BlackbirdStandalone/ToothEater-Firmware/(list of files, drawings)

Other design files:
simulation/ToothEater.sim1
