BlackbirdStandalone/ToothEater-Firmware/src/ToothEater.c

/* -------------------------------------------------------------------------- */
/* Tooth Eater Firmware: v1.2                                                 */
/*                                                                            */
/* Copyright © 2026 Alex Kiaos                                                */
/*                                                                            */
/* Processor: atTiny85                                                        */
/* Licence:   GPLv3                                                           */
/* -------------------------------------------------------------------------- */

#include <avr/interrupt.h>

#include "main_defs.h"
#include "BB_Cam_To_SinglePulse.h"

/* Crank ISR                                                                  */
/*                                                                            */
/* This interrupt service routine fires on every positive crank edge.         */
/* The watchdog is routinely patted on every crank edge after initial cam     */
/* SYNC has been made.                                                        */
ISR (PCINT0_vect)
{
#ifdef INVERT_CRANK_INPUT
    if (!(PINB & (1 << CRANK_TRIG_IN)))
#else
    if (PINB & (1 << CRANK_TRIG_IN))
#endif
    {
#if (0)
        /* Check for hard lockup condition                                    */
        if (FLAGS & BIT_HARD_LOCKUP)
        {
            while(1) {}
        }
#endif
        /* Process crank edge                                                 */
        if (cam.state == SYNCED)
        {
#ifdef CPI_MODE
            /* --- Cam signal insertion ---                                   */
            if (0 == cam.nCrankModCount)
            {
#ifdef CAM_PULSES_ON_STARTUP_ONLY
                if (cam.nCamPulseCount < STARTUP_CAM_PULSES)
                {
                    CAM_OUTPUT_ON
                    ++cam.nCamPulseCount;
                }
                else
                {
                    CAM_OUTPUT_OFF
                }
#else
                CAM_OUTPUT_ON
#endif

                cam.nCrankModCount = CKP_PER_ENGINE_CYCLE;
            }
            else
            {
                CAM_OUTPUT_OFF
            }

            --cam.nCrankModCount;
            /* --- end Cam signal insertion ---                               */
#endif

#ifdef TACHO_ENABLE
            /* --- Tacho signal insertion ---                                 */
            if (0 == cam.nTachoModCount)
            {
                TACHO_TOGGLE

                cam.nTachoModCount = TACHO_HALF_PERIOD;
            }

            --cam.nTachoModCount;
            /* --- end Tacho signal insertion ---                             */
#else
            /* Test line to measure CPU load                                  */
            TACHO_ON
#endif
        }
        else
        {
            doCrankPulse();
        }

        /* Pat the watch dog, but only if past the 'UNINITIALISED' state,     */
        /* since the engine is now cranking or running                        */
        if (cam.state > UNINITIALISED)
        {
            WDG_PAT();
        }
    }
}

/* Cam ISR                                                                    */
/*                                                                            */
/* This interrupt service routine fires on every falling cam edge (default).  */
/* The NCV1124 VR chip was used during development and its output is inverted.*/
/* The state machine is driven by 'doCamPulse()' and the watchdog is always   */
/* patted once the first cam pulse has passed.                                */
/*   If a HARD LOCKUP is invoked, then this ISR is intentionally jammed to    */
/* invoke the WDG and reset the microcontroller.                              */
ISR (INT0_vect)
{
    if (FLAGS & BIT_HARD_LOCKUP)
    {
        while(1) {}
    }

    doCamPulse();

    /* Pat the watch dog, but only if past the 'UNINITIALISED' state, since   */
    /* the engine is now cranking or running                                  */
    if (cam.state > UNINITIALISED)
    {
        WDG_PAT();
    }
}

/* Configure cam ISR pin                                                      */
/* Enable the external interrupt line INT0                                    */
static void externalInterrupt(void)
{
    GIMSK |= (1 << INT0);

#ifdef INVERT_CAM_INPUT
    /* Fire cam ISR on falling edge                                           */
    MCUCR &= ~(1 << ISC00);
#else
    /* Fire cam ISR on rising edge                                            */
    MCUCR |= (1 << ISC00);
#endif

    MCUCR |= (1 << ISC01);
}

/* Configure crank ISR pin                                                    */
/* Listen for a bit polarity change on PB1, invoking 'PCINT0_vect' if so      */
static void pinChangeInterrupt(void)
{
    GIMSK |= (1 << PCIE);
    PCMSK |= (1 << PCINT1);
}

/* The AVR clock default is 1Mhz. Enforce 8Mhz operation                      */
static void setupClockRate8Mhz(void)
{
    CLKPR = 0x80;
    CLKPR = 0x00;
}

/* Setup watchdog timeout to 0.250 secs (250 mSecs).                          */
/* Start out with the watch dog disabled.                                     */
static void setupWatchDog(void)
{
    DISABLE_WDG
    WDTCR = (1 << WDP2);
}

/* Pin setup:                                                                 */
/*                                                                            */
/* INPUTS:  PB2: CAM (input ISR trigger)                                      */
/*          PB1: CRANK (input ISR trigger)                                    */
/*                                                                            */
/* OUTPUTS: PB0: CAM (processed output to ECU)                                */
/*          PB4: CRANK enable pass-through (output to ECU)                    */
/*          PB3: Tacho output                                                 */
/*                                                                            */
static void setupPins(void)
{
    /* Setup output ports                                                     */
    DDRB |= (1 << CAM_OUT_ENABLE);
    DDRB |= (1 << CRANK_OUT_ENABLE);
    DDRB |= (1 << TACHO_OUT);

    /* On start-up, ensure both CAM and CRANK output enable lines are OFF     */
    CAM_OUTPUT_OFF
    CRANK_OUTPUT_OFF
    TACHO_OFF

    /* Cam (PB2) & crank (PB1) input ports for (ISR).                         */
    DDRB &= ~(1 << CAM_TRIG_IN);
    DDRB &= ~(1 << CRANK_TRIG_IN);

    /* Default on input pins is IPU. Inputs are driven by the VR chip outputs */
#ifdef ACTIVATE_INTERNAL_PULLUPS
    PORTB |= (1 << CAM_TRIG_IN);
    PORTB |= (1 << CRANK_TRIG_IN);
#else
    PORTB &= ~(1 << CAM_TRIG_IN);
    PORTB &= ~(1 << CRANK_TRIG_IN);
#endif
}

/* The entire system is interrupt driven. main() is only used to setup the    */
/* micro on startup. Then loop continuously unless a hard lock up is invoked  */
int main(void)
{
    cli();

    initCamSinglePulse();

    setupClockRate8Mhz();
    setupWatchDog();
    externalInterrupt();
    pinChangeInterrupt();
    setupPins();

    sei();

    while (!(FLAGS & BIT_HARD_LOCKUP))
    {
#ifndef TACHO_ENABLE
        TACHO_OFF
#endif
    }
}
