BlackbirdStandalone/ToothEater-Firmware/(commit log)

2026-05-14 - Initial commit
    [ToothEater.sim1]
2026-05-14 - Readme
    [ToothEater.sim1]
2026-06-10 - Preparing for v1.1 release. - Added 'INVERT_CAM_INPUT' switch to fire the cam ISR on either falling or rising edge from the VR. The NCV1124 VR chip has inverted output when the engine is cranked.
    [ToothEater.sim1]
2026-06-12 - Added a switch optionally activate or deactivate the pull-ups on the input pins. I.e. 'ACTIVATE_INTERNAL_PULLUPS'
2026-06-14 - Added a switch to invert crank ISR polarity if needed. I.e. 'INVERT_CRANK_INPUT'
    [ToothEater.c, main_defs.h]
2026-06-14 - Adding cam pulse insertion mode 'CPI mode' with fast startup.
    [ToothEater.sim1]
2026-06-14 - Re-purposed the use of the TEST led to display CPU utilisation. This is done by measuring the ON time in the crank ISR. The crank ISR turns the test line ON, then it is turned OFF in main(). This i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
2026-06-18 - Added tacho output on PB4 (pin 3). Previously was the crank out, but function has now changed to tacho due to slight re-achitecture.
    [ToothEater.sim1]
2026-06-21 - Inserted a preliminary state 'WAIT_FOR_2' to 'release' the crank signals to the ECU in a deterministic way just prior to SYNC. - Changed arrangement to now represent the following: PB4 - Crank outp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
    [ToothEater.sim1]
2026-06-22 - Added a switch to either use the tacho output line as a tacho output (default), or as a CPU load test pin for use on the scope.
2026-06-29 - Update simulator file.
    [ToothEater.sim1]
2026-07-13 - Adding a strategy to only release a defined number of cam pulses on engine start only. This is to overcome an issue where rusefi wants to internally manage its own cam sync after the engine is star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
    [BB_Cam_To_SinglePulse.c, BB_Cam_To_SinglePulse.h, ToothEater.c, main_defs.h]
2026-07-17 - Preparing for v1.2 release. - Blending 'original' and 'cpi' strategies. Selectable via compiler switches defined in the makefile.
